LARM-UFSC/robo_trekking/software/VisãoComputacional/DocumentacaoYolo.md

# Visão Computacional RoboTrekking
> Documentação da parte de detecção de objetos embarcada

> Última atualização: 03/11/2026 por Arthur Fogliato

> Esta documentação descreve a organização dos arquivos, as tecnologias utilizadas, o processo de treinamento e exportação do modelo e sua integração ao software embarcado.

## 1. Introdução: Visão geral
Este projeto é baseado na categoria **Trekking** de robótica. Robôs deste modelo são sistemas autônomos projetados para navegar em determinado cenário com **autonomia completa**. O percurso geralmente exige que o robô saiba lidar com diferentes obstáculos, terrenos e situações. O objetivo é alcançar pontos de controle ou **objetos em específico**, e aqui entra a necessidade da **Visão Computacional Embarcada**.

No cenário em questão, o **Arduino Uno Q** possui um microprocessador(MPU) com ambiente Linux, capaz de executar aplicações em Python e rodar modelos treinados de Inteligência Artificial na borda. O MPU recebe imagens de uma câmera integrada à carenagem. O módulo de visão computacional é responsável por **processar esses dados e fornecer informações pertinentes à utilização no módulo de controle**, sendo orquestrado pelo arquivo _ia_trekking.py_. Dessa forma, as informações obtidas a partir das imagens podem ser utilizadas pela lógica de navegação, em conjunto com os demais recursos do sistema. 

O modelo utilizado foi treinado para reconhecer apenas a classe **cone** em potenciais cenários. As fotos foram selecinoadas visando detecção em imagens com drástica diferença de luz, movimentação e desfoque, além de angulações diferentes. Via Bridge, um _Remote Procedure Call_ interno do Arduino uno Q entre MPU e MCU, o modelo entrega:
 - Posição do cone na câmera em forma de gradiente horizontal: -255 (canto esquerdo), 0(centro) e 255(canto direito). 
 - Classificação estimada de **distância** conforme o tamanho da _bounding box_, crucial para _ia_trekking.py_ classificar entre modos Aproximar, Contornar ou Procurar.

## 2. Detalhes Técnicos

### 2.1. Hardware
| item | especificação |
|---|---|
| Placa | Arduino UNO Q |
| MPU |  Qualcomm QRB2210 |
| MCU | STM32U585 |
| Câmera | Logitech C270 HD  |
| HUB |  Adaptador USB-C  |

### 2.2. Software
| item | versão |
|---|---|
| OS | Linux 13 |
| Python | 3.13 |
|Ultralytics | 8.4.34 |
| OpenCV | python-headless|

### 2.3. Modelo
| Parâmetro | especificação |
|---|---|
|Arquitetura|YOLO26n(detecção)|
|  Formato  | NCNN |
|  Classes  | 1(cone) |
| Resolução | 320x320 |
| Confiança | 0.8 |
|  Dataset  | em  /dataset  |

> a câmera pode ser substituída por outras compatíveis com V4L2. o HUB é genérico.

> detalhes de outras partes do robô podem ser encontrados em outras partes do projeto

## 3. Termos Relacionados

### 3.1. Visão computacional
- **YOLO:** um algoritmo de detecção e classificação de objetos em imagens em tempo real;
- **Detecção vs. segmentação:** segmentação marca pixel a pixel do objeto. No projeto, utilizamos Deteccção: apenas a Bounding Box;
- **Bounding box:** retângulo que envolve o objeto detectado. "caixa" de coordenadas x1, x2, y1, y2;
- **Classe:** é possível criar e treinar para quantas classes forem desejadas. Aqui, foi escolhido apenas Cone;
- **Inferência:** é a utilização do modelo já treinado para o reconhecimento desejado. é a aplicação a cada frame da câmera;
- **Confiança(`conf`):** A certeza de que tal detecção é determinada classe. No projeto, abaixo de 0,8 é descartado;

### 3.2. Treinamento
- **Dataset:** conjunto de imagens coletadas e rotuladas;
- **Anotação (rótulo / label):** marcação manual, realizada por um humano em cada imagem;
- **Fine-tuning (transfer learning):** reaproveitar um modelo já treinado, ajustando-o para os objetos de interesse;
- **Época:** quantidade de tentativas de treinamento e refinamento até o resultado final;

### 3.3. Formatos e arquivos
- **YAML:** arquivo formato de texto, utilizado para configuração do treinamento;
- **NCNN:** um dos formatos de modelo final exportado pelo ultralythics. NCNN é leve, feito para rodar em CPUs de dispositivos embarcados;
- **rotulação YOLO:** formato .txt. ex: 0 0.871 0.395 0.238 0.671;
- **rotulação COCO:** formato JSON. ex: "image_id": 1, "category_id": 1, "bbox": [120, 80, 60, 150];

### 3.4. Ferramentas e bibliotecas
- **Ultralytics:** biblioteca Python que implementa o YOLO; treina, exporta e executa o modelo;
- **OpenCV:** biblioteca para lidar com imagens e vídeos. No projeto, registra as os frames da câmera;
- **Roboflow:** uma das plataformas online para anotar as imagens e organizar o dataset;

## 4. Treinamento

Na prática, ocorre de forma simples. É realizado rodando _Treiner.py_ no terminal. O modelo pode ser treinado diretamente no PC utilizando a GPU. Caso necessário, também é possível rodar no _Google Colab_ ou na CPU de forma mais lenta, se a GPU não for NVIDIA.

### 4. 1. Passo a Passo
1. coletar fotos do(s) objeto(s) e cenários de interesse, com diversidade de luminosidade, distância e angulação.
2. criar um projeto no *RoboFlow* ou outro ambiente de classificação, fazer upload das fotos e anotar manualmente com a opção *bounding box tool*.
3. exportar no formato YOLO para 'VisãoComputacional/dataset/', junto com 'data.yaml'.
4. conferir ordem das pastas do dataset. A estrutura precisa estar como no item 5 deste documento.
5. garantir biblioteca ultralytics instalada no ambiente.
6. acessar a pasta e rodar "python Treiner.py.
7. o **best_ncnn_model* deve ser resultado e estar no caminho indicado.

### 4. 2. configuração
    Todos estes parâmetros podem ser adaptados a um possível novo treinamento.
```python
model.train(
    data=yaml_path,     
    epochs=100,
    imgsz=320,          # resolucao baixa para inferencia rapida
    batch=32,
    patience=20, 
    device=0,           # usa a placa de video local
    project=runs_dir,
    name='trekking_ncnn',
    save=True
)
```
## 5. Estrutura de Pastas
    VisãoComputacional
        ├── Treiner.py 
        ├── DocumentacaoYolo.md  
        ├── best_ncnn_model/     
        └── dataset/
            ├── data.yaml        
            └── train/
                ├── images/       
                └── labels/       

## 6. Integração ao Robô
O modelo é usado no arquivo **\robo_trekkig\software\ArduinoUnoQ\ia_trekking.py**, que roda no Linux do Arduino UNO Q. É executado em loop: **capturar frame → detectar cone → calcular posição e distância → enviar ao MCU**. No projeto, o arquivo é 

### 6. 1. carregamento, inferência e cálculo de posição respectivamente.

```python
MODEL_PATH = str(BASE_DIR.parent / "VisãoComputacional" / "best_ncnn_model")
model = YOLO(MODEL_PATH, task='detect')
```

```python
results = model(frame, conf=0.8, imgsz=320, verbose=False)
```

```python
def CalcularDirecao(cx):                        # cx é o centro horizontal
    gradiente = int((cx - 320) * 255 / 320)     # 320 é o centro da imagem
    return max(-255, min(255, gradiente))
```

### 6. 2. comunicação e envio ao MCU

```python
bridge.call("processa_direcao", gradiente, modo)    # comando interno do arduino entre MPU e MCU
```
### 6. 4. inicialização automática
O programa é registrado como um **serviço do systemd** `ia-trekking.service` e é iniciado automaticamente quando o Linux do UNO Q liga, sem necessidade de acesso via SSH. Ele roda continuamente até a placa ser desligada ou o serviço ser parado. O arquivo fica em /etc/systemd/system/ia-trekking.service no Arduino.

### 6. 3. opção modo visual
conectando via ssh, rodando o programa no terminal com a flag *--visual*, é possível conferir o que a câmera vê, e os dados registrados em tempo real, acessando http://192.168.1.194:8000/video. para evitar interferência, pausar e desabilitar momentaneamente o serviço de systemctl, rodando *sudo systemctl stop ia-trekking* e *sudo systemctl disable ia-trekking* no terminal. ao final, para reabilitar o serviço systemctl, basta rodar sudo systemctl enable ia-trekking.

```bash
python3 ia_trekking.py --visual
```

## 7. Problemas Encontrados e Soluções; debug e comandos;

### 7. 1. `ImportError: libGL.so.1`

- **Causa:** `opencv-python` e `opencv-python-headless` instalados ao mesmo tempo. A versão completa exige bibliotecas gráficas que a placa não possui.
- **Solução:** `pip uninstall opencv-python`, mantendo só o `headless`.

### 7. 2. `ModuleNotFoundError: No module named 'arduino'`

- **Causa:** o módulo `arduino.app_utils` só existe dentro dos containers Docker do Arduino App Lab. Ele não pode ser instalado com `pip` no Linux da placa.
- **Solução:** usar o pacote oficial `arduino-router-bridge` (`pip install arduino-router-bridge`), que funciona fora do App Lab. O código deixa de ser `Bridge.call(...)` e torna-se uma instância no código:
  ```python
  from arduino.router_bridge import Bridge
  bridge = Bridge()
  bridge.connect()
  bridge.call("processa_direcao", gradiente, modo)
  ```

### 7. 3. `libGL`, `No module named 'ultralytics'`, `No module named 'arduino'` em loop.
- **Causa:** o PyTorch padrão tenta buscar bibliotecas de GPU NVIDIA, que o UNO Q não possui.
- **Solução:** instalar a versão **CPU** do PyTorch.

### 7. 4. outros comandos geralmente utilizados em atualização e debug
```bash 
arduino-cli compile --upload --fqbn arduino:zephyr:unoq -p /dev/ttyACM0
systemctl status ia-trekking        
journalctl -u ia-trekking -f
pip show ultralytics                # versão instalada
```

## 8. Referências
1. datasheet Arduino UNO Q: https://docs.arduino.cc/resources/datasheets/ABX00162-ABX00173-datasheet.pdf
2. documentação oficial YOLO: https://docs.ultralytics.com/pt
3. plataforma de anotação: https://roboflow.com
4. projeto: https://github.com/LARM-UFSC/robo_trekking
