LARM-UFSC/robo_trekking/software/ArduinoUnoQ/ia_trekking.py

# pendencias:
#


import cv2
import time
import os
import sys
import glob
import argparse #visual, versao python de argc argv

from ultralytics import YOLO
from arduino.router_bridge import Bridge 
from pathlib import Path

bridge = Bridge()
bridge.connect(timeout=5)

BASE_DIR = Path(__file__).resolve().parent
MODEL_PATH = str(BASE_DIR.parent / "VisãoComputacional" / "best_ncnn_model")

frame_count = 0
start_time = time.time()

try:
    model = YOLO(MODEL_PATH, task='detect')
    print("YOLO carregado")
except Exception as e:
    print(f"Erro ao carregar o modelo: {e}")
    sys.exit()

contornando = False

CAM_GLOB = '/dev/v4l/by-id/*046d_0825*index0'

#==================================================================
def abrirCamera():
    caminhos = sorted(glob.glob(CAM_GLOB))
    if not caminhos:
        return None
    caminho_real = os.path.realpath(caminhos[0])
    try:
        indice = int(caminho_real.replace('/dev/video', ''))
    except ValueError:
        print(f"Não consegui extrair índice de {caminho_real}")
        return None
    c = cv2.VideoCapture(indice, cv2.CAP_V4L2)
    if not c.isOpened():
        c.release()
        return None
    c.set(cv2.CAP_PROP_FRAME_WIDTH, 640)
    c.set(cv2.CAP_PROP_FRAME_HEIGHT, 480)
    c.set(cv2.CAP_PROP_BUFFERSIZE, 1)
    print(f"Camera aberta em /dev/video{indice} (symlink: {caminhos[0]})")
    return c

LIMITE_GRAB_MS = 5.0
MAX_DESCARTES  = 8

def frameMaisRecente(c):
    for _ in range(MAX_DESCARTES):
        inicio = time.time()
        if not c.grab():
            return False, None
        if (time.time() - inicio) * 1000.0 > LIMITE_GRAB_MS:
            break
    return c.retrieve()

cap = abrirCamera()
falhas = 0

#================================================

def Vendo(results):
    for r in results:
        if r.boxes:
            for box in r.boxes:
                nome = model.names[int(box.cls[0])]

                if nome == "cone":
                    x1, y1, x2, y2 = box.xyxy[0].cpu().numpy()
                    return y1, y2

    return None

#==============================================

def CalcularDirecao(cx):
    gradiente = int((cx - 320) * 255 / 320)

    return max(-255, min(255, gradiente))   

#===============================================

ALTURA_PERTO_PX = 300  # calibrar

def Perto(y1, y2):
    return (y2 - y1) >= ALTURA_PERTO_PX

#================================================

def DecidirModo(results, contornando):
    dados = Vendo(results)
    
    if dados is not None:   
        y1, y2 = dados
        
        if Perto(y1, y2):
            contornando = True
            return "estacionar", contornando
        else:
            contornando = False
            return "aproximar", contornando
    else:
        if contornando:
            return "estacionar", contornando
        else:
            return "procurar", contornando
      

#====================================loop=====================================#
def loop():
    global frame_count, start_time, cap, falhas, contornando

    if cap is None:
        cap = abrirCamera()
        if cap is None:
            time.sleep(1.0)
            return
        falhas = 0

    ret, frame = frameMaisRecente(cap)
    if not ret:
        falhas += 1
        if falhas >= 10:
            print("Camera caiu, reabrindo...")
            cap.release()
            cap = None
            falhas = 0
        return

    falhas = 0

    results = model(frame, conf=0.8, imgsz=320, verbose=False)
    gradiente = 0
    encontrou = False
    modo, contornando = DecidirModo(results, contornando)

    for r in results:
       if r.boxes:
            for box in r.boxes:
                nome = model.names[int(box.cls[0])]

                if nome == "cone":
                    x1, y1, x2, y2 = box.xyxy[0].cpu().numpy()

                    cx = (x1 + x2) / 2

                    gradiente = CalcularDirecao(cx)
                    encontrou = True
                    break
            if encontrou: #so pra corrigir o caso especifico de ser 0 no gradiente
                break

    try:
        bridge.call("processa_direcao", gradiente, modo)
    except Exception as e:
        print(f"Erro na chamada da Bridge: {e}")    

    if VISUAL:
        AtualizarFrame(results, gradiente, modo)   

    frame_count += 1
    
    if frame_count >= 30:
        end_time = time.time()
        fps = 30 / (end_time - start_time)
        print(f" Gradiente enviado: {gradiente} | Modo: {modo} | FPS: {fps:.2f} ---")
        frame_count = 0
        start_time = time.time()
#====================================||==========================================#


#==========parte visual==========#


parser = argparse.ArgumentParser()
parser.add_argument('--visual', action='store_true', help='pra ver no navegador o que a camera ta vendo + printar distancias dos ultrassons')
args = parser.parse_args()
VISUAL = args.visual

if VISUAL:
    from http.server import BaseHTTPRequestHandler, HTTPServer
    import threading

    frame_visual = None
    lock_visual = threading.Lock()

    class VisualHandler(BaseHTTPRequestHandler):
        def do_GET(self):
            if self.path == '/video':
                self.send_response(200)
                self.send_header('Content-Type', 'multipart/x-mixed-replace; boundary=frame')
                self.end_headers()
                while True:
                    with lock_visual:
                        atual = frame_visual
                    if atual is None:
                        time.sleep(0.01)
                        continue
                    self.wfile.write(b'--frame\r\n')
                    self.wfile.write(b'Content-Type: image/jpeg\r\n')
                    self.wfile.write(f'Content-Length: {len(atual)}\r\n\r\n'.encode())
                    self.wfile.write(atual)
                    self.wfile.write(b'\r\n')
                    time.sleep(0.03)

    def iniciar_servidor_visual():
        HTTPServer(('0.0.0.0', 8000), VisualHandler).serve_forever()

    threading.Thread(target=iniciar_servidor_visual, daemon=True).start()
    print("modo visual ativado: http://192.168.1.194:8000/video")


def AtualizarFrame(results, gradiente, modo):
    global frame_visual
    anotado = results[0].plot()

    cv2.putText(anotado, f"Gradiente: {gradiente} | Modo: {modo}", (10, 30),
                cv2.FONT_HERSHEY_SIMPLEX, 0.7, (0, 255, 0), 2)

    dados = Vendo(results)
    if dados is not None:
        altura = dados[1] - dados[0]
        cv2.putText(anotado, f"Altura bbox: {altura:.0f}px", (10, 90),
                    cv2.FONT_HERSHEY_SIMPLEX, 0.7, (0, 255, 0), 2)

    ok, buffer = cv2.imencode('.jpg', anotado)
    if ok:
        with lock_visual:
            frame_visual = buffer.tobytes()
#===============fim opcao visual=================#


if __name__ == "__main__":
    try:
        while True:
            loop()
            time.sleep(0.01)
    except KeyboardInterrupt:
        try:
            bridge.call("processa_direcao", 0, "procurar")
        except:
            pass
        if cap is not None:
            cap.release()
