LARM-UFSC/robo_trekking/(commit log)

2026-08-04 Modelo IA
    Modelo de Computer Vision atual.
    [model.ncnn.param]
2026-08-14 Adiciona firmware ESP32 (projeto PlatformIO) em software/ESP32/firmware_esp32
    Nos de leitura do MPU6050 e do sensor ultrassonico, com main.cpp integrando os dois. Cache de build (.pio) fora do versionamento via .gitignore.
2026-08-17 Remove residuos de ESP-IDF do firmware_esp32 e ignora CLAUDE.md
    O projeto usa PlatformIO com framework Arduino, entao dependencies.lock
    (lockfile do component manager do ESP-IDF, referenciando espressif/mpu6050
    e idf 6.0.1) e .vscode/settings.json (apenas idf.currentSetup) nao tinham
    efeito no build.
    CLAUDE.md entra no .gitignore por ser configuracao local de ferramenta.
2026-08-19 Adiciona acionamento dos motores e remove firmware ESP32 antigo
    Cria o node de motores (motores_node.cpp/.hpp) com o acionamento que
    faltava: a cadeia camera -> comando -> motor terminava em Serial.print e
    nenhum ledcWrite de acionamento existia.
    - acionarPonte() zera o canal oposto antes de acionar, evitando os dois
    lados da ponte H ativos ao mesmo tempo; o sinal do parametro escolhe o
    sentido.
    - aplicarComando() mapeia L/R/F/S em tracao mais esterco. A tracao fica
    ligada em L, R e F; qualquer outro byte para os motores.
    - O esterco e pulsado (250 ms on / 250 ms off) porque o motor de direcao
    e DC sem realimentacao de posicao e travaria no batente se acionado de
    forma continua.
    -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
2026-08-19 Atualiza READMEs para o firmware PlatformIO do ESP32
    A documentacao ainda mandava abrir software/ESP32/main.cpp, arquivo
    removido no commit anterior, e descrevia o firmware como somente leitura
    de sensores.
    - software/ESP32/README.md: reescrito para o projeto PlatformIO. Estrutura
    em nodes, dependencias, comandos pio, mapa de pinos, protocolo da camera
    e divisao entre os dois nucleos. Documenta por que o esterco e pulsado.
    - software/README.md: arvore de diretorios, descricao do modulo ESP32,
    requisitos e passo de compilacao passam a refletir o projeto PlatformIO.
    O passo 6 do fluxo agora cita o acionamento dos motores.
    Registra tambem as limitacoes conhecidas: o acionamento dos mo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
2026-08-20 Adiciona firmware do MCU do Arduino Uno Q
    Porte do firmware do ESP32 para o MCU do Uno Q (STM32U585, core
    arduino:zephyr). Consolida o robo numa placa so: a CPU Linux ja roda a
    inferencia e agora entrega o comando direto ao MCU pela Bridge, sem
    passar por um segundo microcontrolador.
    O que mudou em relacao ao ESP32:
    - NewPing sai. A biblioteca faz manipulacao direta de porta AVR/ESP e nao
    funciona no STM32. A leitura do HC-SR04 passa a ser trigger manual mais
    medicao do eco com digitalRead e micros(), sem depender de pulseIn, que
    nao esta documentado como suportado no core Zephyr.
    - xTaskCreatePinnedToCore sai. O STM32U585 e single core e roda Zephyr,
    nao FreeRTOS. Os sonares passa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
2026-08-24 Unifica o trigger dos ultrassonicos, adiciona re e nomeia os sensores
    Trigger compartilhado: os sensores passam a usar um unico pino de disparo
    (D2). Como um disparo faz todos emitirem juntos, ler em rodizio faria os
    sensores dispararem varias vezes por ciclo, um interferindo no outro. A
    leitura agora dispara uma vez e mede os tres ecos do MESMO disparo,
    varrendo os pinos num laco e registrando subida e descida de cada um.
    Alem de correto, o ciclo cai para no maximo 25 ms e as tres distancias
    passam a ser um retrato do mesmo instante.
    Comando 'B' de re: aciona a tracao no sentido oposto com duty proprio
    (dutyRe = 140, abaixo dos 178 da marcha a frente, por ser manobra sem
    visao do que esta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
    [firmware_unoq.ino]
2026-09-03 Desativando ultrassom temporariamente, ajuste no tempo da fase ativa do motor
2026-09-03 Substitui pulso do esterco por acionamento continuo com teto de tempo
    O esterco tem mola de centragem: a deflexao so se sustenta com o motor
    acionado, e o duty define o ponto de equilibrio entre o torque do motor e a
    mola. O pulso de 250 ms funcionava como um PWM de 2 Hz por cima do PWM real e
    fazia o esterco oscilar entre a deflexao e o centro, em vez de segurar o
    angulo pedido.
    A fase do pulso tambem era medida a partir da troca de comando, entao comando
    alternando reiniciava a fase e mantinha o esterco acionado continuamente --
    justamente o rotor bloqueado que o pulso deveria evitar.
    - dutyDirecao de 178 para 120; ajuste de bancada pendente
    - TEMPO_ESTERCO_MS sai, entram ESTERCO_MAX_MS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
2026-09-04 Aplicando tentatica de reconexão da camera
2026-09-08 Separação do codigo do MCU em nós e implimentação do failsafe
    [firmware_unoq.ino, motores.hpp, mpu.hpp, ultrassom.hpp]
2026-09-10 novo modelo, agora nao segmenta. adicionado git ignore
    [model.ncnn.param]
2026-09-10 codigo de funcionamento alterado pra detect, nao segment
2026-09-16 Aplicacao dos sensores de ultrassom para tomada de decisao. 3 sensores presentes no robo atualmente
2026-09-17 Sistema para coleta de dados do ultrassom
2026-09-18 Log de distancias do ultrassom
2026-09-18 atualizacao de log + flag visual ssh
2026-09-24 Algoritmo de manobra
2026-09-25 Implementacao de logica fuzzy no desvio e movimento
2026-09-28 Limpeza de funções em desuso e fixando mudanças
    [firmware_unoq.ino, ia_trekking.py, ultrassom.hpp]
2026-09-28 Parando de anotar as distancias medidas
2026-10-01 desenho na matriz de led do modo atual
2026-10-01 Implementação de modos de operação
2026-10-05 Correção modos de operação
2026-10-06 correção de bugs residuas da reorganização
    [ia_trekking.py, travas.hpp]
2026-10-07 Correção angulo de centralização do cone
2026-10-13 Mudança de lógica do contorno
2026-10-13 ajustes de angulo
2026-10-20 nova versao para 4 eixos
2026-10-22 novo motores.hpp
2026-10-23 motores pronto; preparando para ultrassons receber de 6 ultrassons
2026-10-26 motores.hpp e ultrassom.hpp atualizados
2026-10-27 motores e ultrassons agora são classes
2026-11-03 Compensa troca de bateria 8,4V->12V e troca contornar por estacionar ao chegar no cone
    Aplica fator de tensao (8,4/12) sobre toda saida de velocidade (duty de
    tracao/re, busca, contorno, fuzzy) para manter o mesmo comportamento calibrado
    a 8,4V. Direcao (esterco) fica de fora, por ser torque contra mola/batente.
    DecidirModo() do ia_trekking.py passa a mandar modo "estacionar" em vez de
    "contornar" quando o cone esta perto; firmware_unoq.ino ganha a letra 'e' no
    despacho de modos, so zerando vel/dir.
